TonyInvent/OpenIMU/3D/preview.png

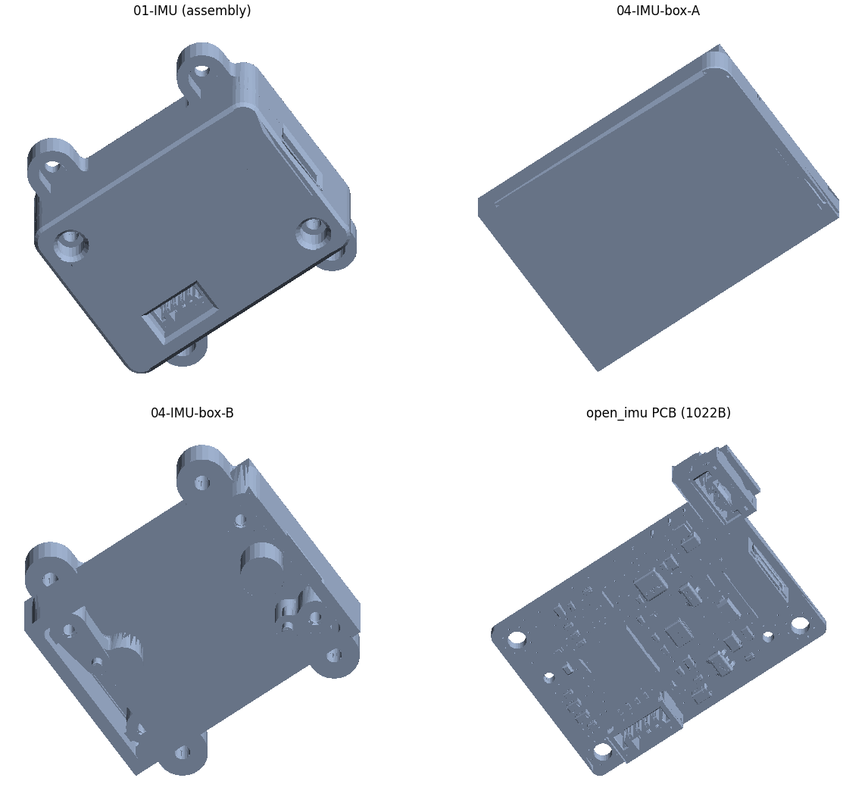
3D/preview.png
