TonyInvent/OpenIMU/3D/20261028/04-IMU-box-B.FCStd

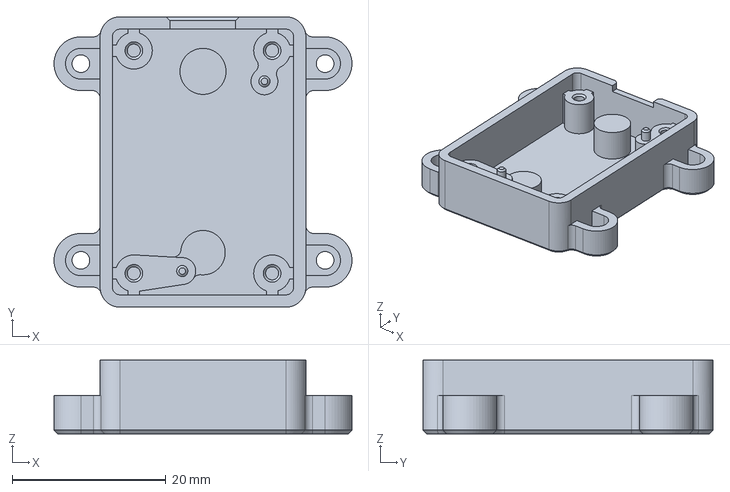
[picture p5: CAD file, 2026-10-28]
3D/20261028/04-IMU-box-B.FCStd
38.8 x 37.8 x 9.60 mm
