TonyInvent/OpenIMU/3D/20261028/04-IMU-box-A.FCStd

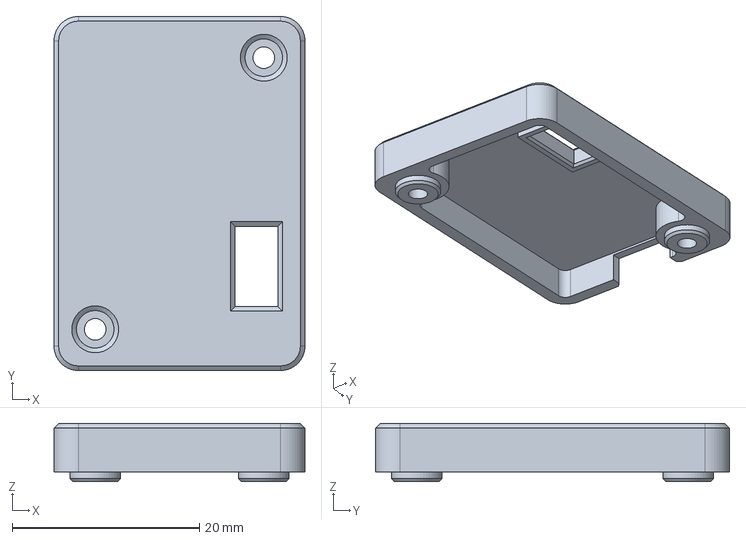
[picture p6: CAD file, 2026-10-28]
3D/20261028/04-IMU-box-A.FCStd
26.8 x 37.8 x 6.20 mm
