TonyInvent/OpenIMU/3D/20261028/open_imu_3D_1022B.FCStd

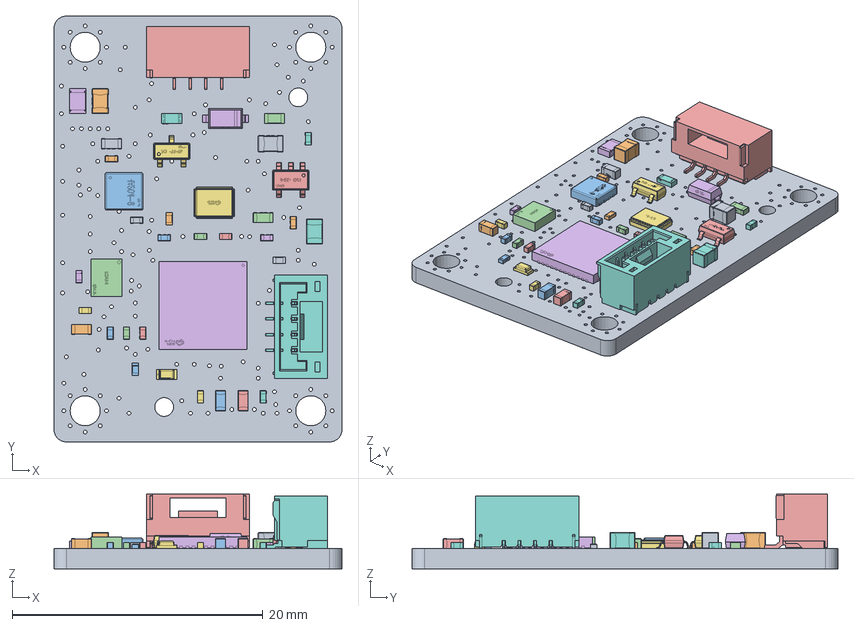
[picture p7: CAD file, 2026-10-28]
3D/20261028/open_imu_3D_1022B.FCStd
23.0 x 34.0 x 5.95 mm
Board~N964
C0402~C0402_L1.0-W0.5-H0.5~D99M
C0402~C0402_L1.0-W0.5-H0.5~D99M001
C0402~C0402_L1.0-W0.5-H0.5~D99M002
C0402~C0402_L1.0-W0.5-H0.5~D99M003
C0402~C0402_L1.0-W0.5-H0.5~D99M004
C0402~C0402_L1.0-W0.5-H0.5~D99M005
C0402~C0402_L1.0-W0.5-H0.5~D99M006
C0402~C0402_L1.0-W0.5-H0.5~D99M007
C0402~C0402_L1.0-W0.5-H0.5~D99M008
C0402~C0402_L1.0-W0.5-H0.5~D99M009
C0402~C0402_L1.0-W0.5-H0.5~D99M010
C0402~C0402_L1.0-W0.5-H0.5~D99M011
C0402~C0402_L1.0-W0.5-H0.5~D99M012
C0402~C0402_L1.0-W0.5-H0.5~D99M013
C0402~C0402_L1.0-W0.5-H0.5~D99M014
C0603~C0603_L1.6-W0.8-H0.8~f4fJ
C0603~C0603_L1.6-W0.8-H0.8~f4fJ001
C0603~C0603_L1.6-W0.8-H0.8~f4fJ002
C0603~C0603_L1.6-W0.8-H0.8~f4fJ003
C0603~C0603_L1.6-W0.8-H0.8~f4fJ004
SOD-123_L2.8-W1.8-LS3.7-RD~SOD-123_L2.8-W1.8-LS3.7-RD~P5vA
LED0603-RD_GREEN~LED0603-RD_GREEN~aO4a
R0603~R0603~sxD8
R0402~R0402_L1.0-W0.5-H0.4~tbHW
R0402~R0402_L1.0-W0.5-H0.4~tbHW001
R0402~R0402_L1.0-W0.5-H0.4~tbHW002
LGA-14_L3.0-W2.5-P0.50-TL~LGA-14_L2.5-W3.0-H0.9-P0.50~VYw3
CONN-SMD_4P-P1.25_XUNPU_WAFER-GH1.25-4PWB~CONN-SMD_4P-P1.25_XUNPU_WAFER-GH1.25-4PWB~I6nu
VQFN-48_L7.0-W7.0-P0.50-BL-EP5.5~VQFN-48_L7.0-W7.0-P0.50-BL-EP5.5~hn36
CRYSTAL-SMD_4P-L3.2-W2.5-BL~CRYSTAL-SMD_4P-L3.2-W2.5-BL~MRwp
C0805~C0805_L2.0-W1.3-H1.3~LhJX
C0805~C0805_L2.0-W1.3-H1.3~LhJX001
C0805~C0805_L2.0-W1.3-H1.3~LhJX002
HVSON-8_L3.0-W3.0-P0.65-BL-EP~HVSON-8_L3.0-W3.0-H0.85-P0.65-BL-EP~NhbZ
L0603~L0603_L1.6-W0.8-H0.5_BEAD~2BmU
TSOT-23-5_L2.9-W1.6-P0.95-LS2.8-BR~TSOT-23-5_L2.9-W1.6-H1.00-LS2.8-P0.95~nDk3
R0805~R0805_L2.0-W1.3-H0.6~Mn3l
SOT-23-3_L2.9-W1.3-P1.90-LS2.4-BR~SOT-23-3P_L2.9-W1.3-H1.0-LS2.4-P0.95~Hdi2
CONN-SMD_4P-P1.25_XUNPU_WAFER-GH1.25-4PLB~CONN-TH_4P-P1.25_XUNPU_WAFER-GH1.25-4PLB~gf5S
