TonyInvent/OpenIMU/(list of files, cad)

Other CAD files:
3D/20261028/01-IMU.FCStd
