TonyInvent/OpenIMU/open_imu.ioc

Mcu.UserName=STM32G431CBUx
PA11.Signal=FDCAN1_RX
PA12.Signal=FDCAN1_TX
PA13.Signal=SYS_JTMS-SWDIO
PA14.Signal=SYS_JTCK-SWCLK
PA4.Signal=SPI1_NSS
PA5.Signal=SPI1_SCK
PA6.Signal=SPI1_MISO
PA7.Signal=SPI1_MOSI
PB0.Signal=GPXTI0
PF0-OSC_IN.Signal=RCC_OSC_IN
PF1-OSC_OUT.Signal=RCC_OSC_OUT
