TonyInvent/OpenIMU/Core/Src/imu_task.c

/**
  ******************************************************************************
  * @file    imu_task.c
  * @brief   FreeRTOS task reading ICM-45686 samples on the INT1 data-ready
  *          interrupt and streaming them over CAN FD (ID 0x01) at 800 Hz.
  *
  *          Flow:
  *            ICM-45686 INT1 (800 Hz data-ready, active-high pulse)
  *                -> PB0 / EXTI0 (rising edge)
  *                -> HAL_GPIO_EXTI_Callback()
  *                -> vTaskNotifyGiveFromISR()
  *                -> IMU task reads 14 bytes over SPI and queues one 16-byte
  *                   CAN FD frame.
  *
  *          CAN FD frame (16 bytes, big-endian multi-byte fields):
  *            [0]    hardware timestamp high (1 us / tick, wraps at 65536 us)
  *            [1]    hardware timestamp low
  *            [2:3]  accel X  (raw int16)
  *            [4:5]  accel Y
  *            [6:7]  accel Z
  *            [8:9]  gyro X   (raw int16)
  *            [10:11]gyro Y
  *            [12:13]gyro Z
  *            [14:15]temperature (raw int16)
  ******************************************************************************
  */
#include "imu_task.h"
#include "icm45686.h"
#include "main.h"
#include "task.h"

/* External peripheral handles from main.c */
extern SPI_HandleTypeDef   hspi1;
extern FDCAN_HandleTypeDef hfdcan1;

/* ------------------------------------------------------------------------- */
/* Task configuration                                                        */
/* ------------------------------------------------------------------------- */
#define IMU_TASK_STACK_BYTES      (256U * 4U)   /* 256 words = 1024 bytes */

static const osThreadAttr_t imu_task_attributes = {
    .name       = "imuTask",
    .priority   = (osPriority_t) osPriorityHigh,
    .stack_size = IMU_TASK_STACK_BYTES
};

/* ------------------------------------------------------------------------- */
/* Status LED (PB2, current-sinking: LOW = ON)                               */
/* ------------------------------------------------------------------------- */
#define LED_GPIO_PORT            GPIOB
#define LED_GPIO_PIN             GPIO_PIN_2

#define LED_ON()      HAL_GPIO_WritePin(LED_GPIO_PORT, LED_GPIO_PIN, GPIO_PIN_RESET)
#define LED_OFF()     HAL_GPIO_WritePin(LED_GPIO_PORT, LED_GPIO_PIN, GPIO_PIN_SET)
#define LED_TOGGLE()  HAL_GPIO_TogglePin(LED_GPIO_PORT, LED_GPIO_PIN)

/* Blink timing */
#define LED_RUN_TOGGLE_FRAMES    100U   /* normal: toggle every 100 frames (~125 ms @ 800 Hz) */
#define LED_ERROR_BLINK_MS       30U    /* error:  toggle every 30 ms (fast blink)             */

/* ------------------------------------------------------------------------- */
/* Private variables                                                         */
/* ------------------------------------------------------------------------- */
static TaskHandle_t imu_task_handle = NULL;   /* used for ISR -> task notify */

/* Diagnostics (inspect in the debugger) */
volatile uint32_t imu_sample_count = 0U;      /* samples enqueued, not TX ACKs */
volatile uint32_t imu_fifo_backlog_count = 0U;/* frames skipped to stay current */
volatile uint32_t imu_fifo_overflow_count = 0U;/* FIFO_FULL status seen        */
volatile uint32_t imu_fifo_reset_count = 0U;  /* device reset seen            */
volatile uint32_t imu_missed_count  = 0U;     /* data-ready overruns         */
volatile uint32_t imu_can_error_count = 0U;   /* CAN queue failures          */
volatile uint32_t imu_spi_error_count = 0U;   /* SPI/FIFO read failures      */

/* Diagnostics: FDCAN protocol status + error counters, refreshed every frame.
 * These capture bus/bit errors that occur AFTER a frame is enqueued (which
 * imu_can_error_count, an enqueue result, cannot see). Watch BusOff,
 * ErrorPassive, LastErrorCode, DataLastErrorCode, TxErrorCnt in the debugger. */
FDCAN_ProtocolStatusTypeDef can_status = {0};
FDCAN_ErrorCountersTypeDef   can_errors  = {0};

static uint32_t led_error_last_tick = 0U;     /* last error fast-blink toggle (ms) */

/* ------------------------------------------------------------------------- */
/* Private function prototypes                                               */
/* ------------------------------------------------------------------------- */
static void IMU_Task(void *argument);

/* ------------------------------------------------------------------------- */
/* Helpers                                                                   */
/* ------------------------------------------------------------------------- */

/**
  * @brief  Pack one sample into the 16-byte CAN FD payload (big-endian).
  */
static void IMU_PackFrame(uint8_t *dst, uint16_t timestamp, const ICM45686_Data_t *d)
{
    dst[0]  = (uint8_t)(timestamp >> 8);
    dst[1]  = (uint8_t)(timestamp & 0xFFU);

    dst[2]  = (uint8_t)((uint16_t)d->accel[0] >> 8);
    dst[3]  = (uint8_t)((uint16_t)d->accel[0] & 0xFFU);
    dst[4]  = (uint8_t)((uint16_t)d->accel[1] >> 8);
    dst[5]  = (uint8_t)((uint16_t)d->accel[1] & 0xFFU);
    dst[6]  = (uint8_t)((uint16_t)d->accel[2] >> 8);
    dst[7]  = (uint8_t)((uint16_t)d->accel[2] & 0xFFU);

    dst[8]  = (uint8_t)((uint16_t)d->gyro[0] >> 8);
    dst[9]  = (uint8_t)((uint16_t)d->gyro[0] & 0xFFU);
    dst[10] = (uint8_t)((uint16_t)d->gyro[1] >> 8);
    dst[11] = (uint8_t)((uint16_t)d->gyro[1] & 0xFFU);
    dst[12] = (uint8_t)((uint16_t)d->gyro[2] >> 8);
    dst[13] = (uint8_t)((uint16_t)d->gyro[2] & 0xFFU);

    dst[14] = (uint8_t)((uint16_t)d->temp >> 8);
    dst[15] = (uint8_t)((uint16_t)d->temp & 0xFFU);
}

/**
  * @brief  Fast-blink the LED once per LED_ERROR_BLINK_MS (error indication).
  * @note   Called from the task loop on each error; the blink rate is limited
  *         by HAL_GetTick() so a burst of errors still produces a clean blink.
  */
static void LED_ErrorBlink(void)
{
    uint32_t now = HAL_GetTick();
    if ((now - led_error_last_tick) >= LED_ERROR_BLINK_MS) {
        LED_TOGGLE();
        led_error_last_tick = now;
    }
}

/**
  * @brief  Fatal error: fast-blink forever (init failure). Never returns.
  */
static void LED_FatalBlink(void)
{
    for (;;) {
        LED_TOGGLE();
        osDelay(LED_ERROR_BLINK_MS);
    }
}

/* ------------------------------------------------------------------------- */
/* Public API                                                                */
/* ------------------------------------------------------------------------- */

void IMU_StartTask(void)
{
    imu_task_handle = osThreadNew(IMU_Task, NULL, &imu_task_attributes);
}

/**
  * @brief  Called from EXTI0 ISR context; wakes the IMU task.
  */
void IMU_DataReadyFromISR(void)
{
    BaseType_t xHigherPriorityTaskWoken = pdFALSE;

    if (imu_task_handle != NULL) {
        vTaskNotifyGiveFromISR(imu_task_handle, &xHigherPriorityTaskWoken);
        portYIELD_FROM_ISR(xHigherPriorityTaskWoken);
    }
}

/**
  * @brief  HAL GPIO EXTI callback (called from EXTI0_IRQHandler via
  *         HAL_GPIO_EXTI_IRQHandler()).
  */
void HAL_GPIO_EXTI_Callback(uint16_t GPIO_Pin)
{
    if (GPIO_Pin == GPIO_PIN_0) {
        IMU_DataReadyFromISR();
    }
}

/* ------------------------------------------------------------------------- */
/* Task body                                                                 */
/* ------------------------------------------------------------------------- */

static void IMU_Task(void *argument)
{
    (void)argument;

    FDCAN_TxHeaderTypeDef TxHeader = {0};
    ICM45686_Data_t       imu      = {0};
    uint8_t               tx_data[IMU_CAN_DLC_BYTES];

    /* 0. Power-on indicator: turn the status LED solid ON. */
    LED_ON();

    /* 1. Initialise the IMU and start the FDCAN peripheral */
    if (ICM45686_Init(&hspi1) != HAL_OK) {
        /* IMU not present / miswired: fast-blink forever. */
        LED_FatalBlink();
    }

    /* 1a. FIFO streaming with the hardware timestamp (1 us / LSB):
     *     watermark = 1 frame, interrupt on count >= watermark, timestamp
     *     included in every 16-byte packet. Check the count after each wake:
     *     notifications may be stale and multiple packets may accumulate. */
    if (ICM45686_ConfigFifo() != HAL_OK) {
        LED_FatalBlink();
    }

    /* 1b. Enable transmitter delay compensation (TDC) for the 5 Mbit/s data
     *     phase. Must be configured while the FDCAN is still in READY state
     *     (i.e. before HAL_FDCAN_Start).
     *     SSP = measured loop delay + TDCO, both in "minimum time quantum"
     *     (mtq) units. With the FDCAN kernel clock at 100 MHz (FDCAN_CLOCK_DIV1),
     *     1 mtq = 10 ns, so TDCO = 16 places the sample point ~160 ns inside
     *     the data bit, away from the edge. (TDCO = 0 samples at the edge and
     *     produces bit errors in the 5 Mbit/s data phase.) */
    if (HAL_FDCAN_ConfigTxDelayCompensation(&hfdcan1, 16U, 0U) != HAL_OK) {
        LED_FatalBlink();
    }
    if (HAL_FDCAN_EnableTxDelayCompensation(&hfdcan1) != HAL_OK) {
        LED_FatalBlink();
    }

    if (HAL_FDCAN_Start(&hfdcan1) != HAL_OK) {
        /* FDCAN failed to start: fast-blink forever. */
        LED_FatalBlink();
    }

    /* 2. Prepare the (constant) CAN FD TX header */
    TxHeader.Identifier          = IMU_CAN_ID;
    TxHeader.IdType              = FDCAN_STANDARD_ID;
    TxHeader.TxFrameType         = FDCAN_DATA_FRAME;
    TxHeader.DataLength          = FDCAN_DLC_BYTES_16;
    TxHeader.ErrorStateIndicator = FDCAN_ESI_ACTIVE;
    TxHeader.BitRateSwitch       = FDCAN_BRS_ON;
    TxHeader.FDFormat            = FDCAN_FD_CAN;
    TxHeader.TxEventFifoControl  = FDCAN_NO_TX_EVENTS;
    TxHeader.MessageMarker       = 0U;

    /* 3. Enable the INT1 / EXTI0 data-ready interrupt (FreeRTOS-safe priority) */
    HAL_NVIC_SetPriority(EXTI0_IRQn, 5, 0);
    HAL_NVIC_ClearPendingIRQ(EXTI0_IRQn);
    HAL_NVIC_EnableIRQ(EXTI0_IRQn);

    /* 4. Acquisition loop: one CAN FD frame per data-ready pulse (800 Hz) */
    for (;;) {
        uint32_t notified = ulTaskNotifyTake(pdTRUE, portMAX_DELAY);

        /* Auto-recover from bus-off. Without a receiver every frame gets an
         * ACK error, which eventually drives the FDCAN into bus-off; clearing
         * INIT lets it recover and keep transmitting. This makes the board
         * plug-and-play with the USB-CAN dongle (no power-up order needed). */
        if ((hfdcan1.Instance->PSR & FDCAN_PSR_BO) != 0U) {
            hfdcan1.Instance->CCCR &= ~FDCAN_CCCR_INIT;
        }

        if (notified > 1U) {
            imu_missed_count += (notified - 1U);
        }

        uint16_t timestamp = 0U;

        /* Keep the FIFO shallow: if a scheduling hiccup let more than one frame
         * queue up, drop the stale ones and transmit only the newest sample.
         * Without this a single stall would leave a permanent latency offset,
         * because each interrupt only ever drains one frame. */
        {
            uint16_t pending = 0U;
            if (ICM45686_ReadFifoCountChecked(&pending) != HAL_OK) {
                imu_spi_error_count++;
                LED_ErrorBlink();
                continue;
            }
            if (pending == 0U) {
                continue;
            }
            while (pending > 1U) {
                if (ICM45686_ReadFifoPacket(&imu, &timestamp) != HAL_OK) {
                    imu_spi_error_count++;
                    pending = 0U;
                    break;
                }
                imu_fifo_backlog_count++;
                pending--;
            }
            if (pending == 0U) {
                LED_ErrorBlink();
                continue;
            }
        }

        if (ICM45686_ReadFifoPacket(&imu, &timestamp) != HAL_OK) {
            imu_spi_error_count++;
            LED_ErrorBlink();
            continue;
        }

        {
            uint8_t fifo_status = 0U;
            if (ICM45686_ReadFifoStatus(&fifo_status) == HAL_OK) {
                if ((fifo_status & ICM45686_STATUS_FIFO_FULL) != 0U) {
                    imu_fifo_overflow_count++;
                }
                if ((fifo_status & ICM45686_STATUS_RESET_DONE) != 0U) {
                    imu_fifo_reset_count++;
                }
            } else {
                imu_spi_error_count++;
                LED_ErrorBlink();
                continue;
            }
        }

        /* [0:1] of the CAN frame carries the sensor's hardware timestamp. */
        IMU_PackFrame(tx_data, timestamp, &imu);

        /* Snapshot protocol status + error counters before queuing the next
         * frame, so post-enqueue bus/bit errors stay visible in the debugger. */
        HAL_FDCAN_GetProtocolStatus(&hfdcan1, &can_status);
        HAL_FDCAN_GetErrorCounters(&hfdcan1, &can_errors);

        if (HAL_FDCAN_AddMessageToTxFifoQ(&hfdcan1, &TxHeader, tx_data) != HAL_OK) {
            imu_can_error_count++;
            /* Frame dropped (TX FIFO full / bus error): fast-blink. */
            LED_ErrorBlink();
        } else {
            imu_sample_count++;
            /* Normal operation: toggle the LED every 100 transmitted frames. */
            if ((imu_sample_count % LED_RUN_TOGGLE_FRAMES) == 0U) {
                LED_TOGGLE();
            }
        }
    }
}
