TonyInvent/OpenIMU/(commit log)

2026-10-21 Initial commit: ICM-45686 IMU (SPI) + CAN FD transmission @ 800 Hz (STM32G431)
2026-10-21 Add status LED (PB2) UI behavior
2026-10-27 Fix IMU bring-up and enable stable CAN FD 16-byte transmission
    - SPI: software CS (PA4), Mode 3, 12.5 MHz (fixes register writes)
    - ICM-45686: corrected init order (DRDY routing enabled after power-on), low-noise UI LPF BW = ODR/4, write + readback verification
    - Accel full-scale corrected to +/-4 g (8192 LSB/g)
    - FDCAN: enable TDC (TDCO=16) for the 5 Mbit/s data phase; auto-recover from bus-off so no receiver power-up ordering is needed
    - Diagnostics: expose FDCAN protocol status + error counters; drop leftover debug globals
2026-10-27 Update README: software SPI chip-select, TDC, and bus-off auto-recovery
    - SPI: PA4 is a software-controlled CS (Mode 3), not hardware NSS
    - Document TDC (TDCO=16, 1 mtq = 10 ns) required for the 5 Mbit/s data phase
    - Document bus-off auto-recovery (no receiver power-up ordering needed)
    - Note the driver now sets the UI low-pass filter to ODR/4
    - Add can_status / can_errors to the diagnostic counters table
2026-10-27 Document ICM-45686 SPI mode/software CS and UI LPFBW encoding
    - Header: SPI is Mode 3 with software CS on PA4 (the old Mode 0 / hardware NSS note was stale)
    - Document the ui_lpfbw_sel encoding (0=OFF, 1=ODR/4 ... 6=ODR/128) and its source (TDK driver / Zephyr dt-bindings)
2026-10-27 Match TDK/BeijingDynamics UI low-pass filter write (read-modify-write)
    - Keep UI LPFBW = ODR/4, the same value used by BeijingDynamics open_sprite_runtime and the TDK reference driver
    - Write only the 3-bit accel_ui_lpfbw_sel / gyro_ui_lpfbw_sel field via read-modify-write (mirrors inv_imu_set_accel_ln_bw / inv_imu_set_gyro_ln_bw) instead of overwriting the whole MREG byte
2026-10-27 Correct end-to-end latency definition in READMEs
    - Measure latency from 'sample ready' to the CAN FD frame being fully on the bus (16 data bytes + CRC + ACK/EOF), not to the first data byte
    - Total = sensor group delay (1-3 ms) + MCU path (~15-20 us) + full frame (~70-80 us) = group delay + ~85-100 us
    - Update the jitter/frame-loss section consistently (~7-8% of the 1.25 ms period)
2026-10-27 Add Linux candump (SocketCAN) setup section to READMEs
    - Document bringing up the CAN FD interface: bitrate 1000000, dbitrate 5000000, fd on
    - Show candump usage and the expected frame format (ID 0x001, [16] bytes)
    - Add a short Python snippet to decode the 16-byte big-endian payload
2026-10-28 Add cross-platform Python AHRS demo (Mahony/Madgwick/SixAxis)
    - tools/ahrs_demo.py: python-can backend (SocketCAN on Linux, PCAN-Basic on Windows), 16-byte CAN FD frame decode, three attitude estimators on the same samples, live 3-D attitude / roll-pitch / world-frame linear-acceleration plots
    - SixAxis is a Python port of BeijingDynamics open_sprite_runtime native/src/imu_six_axis.hpp
    - --simulate (no hardware), --no-plot, --duration, --log CSV
    - READMEs: new section 8 with install/run instructions; ignore __pycache__
2026-10-28 Add FreeCAD 3D models for the IMU board
    - 3D/20261028/: FreeCAD models (IMU carrier, enclosure variant A/B, assembled model), ~6 MB total
    - 3D/README.md: file listing
    - .gitattributes: treat *.FCStd as binary (zip archive, no EOL conversion)
2026-10-28 Add 3D preview and document the enclosure in the READMEs
    - 3D/preview.png: rendered 2x2 grid (assembly, box A/B, PCB) from the FreeCAD models
    - tools/export_3d_stl.py + tools/render_3d_preview.py: reproducible pipeline (FreeCADCmd STL export -> matplotlib render)
    - READMEs: new section 9 with the preview and a PETG printing recommendation
    - 3D/README.md: accurate part descriptions (assembly / box A / box B / PCB)
    - .gitignore: build/ (generated STL meshes)
2026-10-28 Use FreeCAD screenshot for the 3D preview; drop render tooling
    - Replace the rendered 2x2 preview with 3D/open_imu.png (FreeCAD screenshot of the assembly)
    - Remove tools/export_3d_stl.py and tools/render_3d_preview.py
    - Update the image links in README.md, readme_cn.md and 3D/README.md
2026-10-28 Show yaw angle and drift rate in the AHRS demo
    - Add a wide unwrapped-yaw plot (3 filters) and a 'yaw ... (deg/s)' readout in the title
    - Print roll/pitch/yaw for all three filters in --no-plot mode
    - Yaw is unobservable from the accelerometer, so on a static board its slope is the residual gyro bias
    - READMEs: document how to read the yaw plot for static-drift assessment
2026-10-28 Print the current yaw to the console while the demo window is open
    - 4 Hz console line 'yaw ... deg (roll, pitch)' so the board can be aligned while watching the terminal
    - The plot title still shows yaw + drift rate
2026-10-29 Add pure-gyro dead-reckoning demo (attitude + velocity)
    - tools/gyro_dead_reckoning.py: 10 s static calibration (gyro bias + roll/pitch from gravity, yaw = 0), then gyro-only quaternion integration (no accelerometer correction)
    - Rotates the accelerometer into the world frame, removes gravity, integrates once for velocity
    - Live 3-D attitude, motion-acceleration, velocity plots + console velocity readout
    - --simulate mode with a realistic moving board, --no-plot, --duration
    - READMEs: mention the companion demo
2026-10-29 Add displacement (double integration) to the dead-reckoning demo
    - Integrate the velocity once more for position (X-Y-Z + |p|)
    - New 2x3 layout: attitude, motion acceleration, velocity, X-Y drift path, position vs time, info panel
    - Console output and info panel include the current position
    - Simulate mode: phase-aligned acceleration so velocity/position start at zero
    - READMEs: mention the displacement path
2026-10-29 Add a Reset v/p button to the dead-reckoning demo
    - matplotlib Button at the bottom of the window
    - Clicking it zeroes the velocity and position integration, clears the plot histories and restarts the elapsed-time/drift stats
    - READMEs: document the button
2026-10-29 Fix reset-button comment to match behaviour (plots restart from zero)
2026-10-29 Add zero-velocity update (ZUPT) to the dead-reckoning demo
    - ZuptDetector: |gyro| and | |a|-g | thresholds over a sliding window (>=90% still)
    - When active, the velocity is forced to zero so the position stops drifting at rest
    - --zupt plus --zupt-gyro-th / --zupt-accel-th / --zupt-window
    - Info panel and console show the ZUPT state and activation count
    - Simulate mode alternates 3 s moving / 2 s static so ZUPT is exercised
    - READMEs: document the option
2026-10-29 Make ZUPT the default and reset the position on zero-velocity
    - ZUPT is now enabled by default; use --no-zupt to compare against raw open-loop integration
    - When the detector fires, both velocity and position are reset to zero, so every stop re-anchors the origin (short-term displacement only)
    - READMEs: update the ZUPT description
2026-10-29 Track the gyro bias online during ZUPT to compensate temperature drift
    - While ZUPT is active the gyro reading is the bias, so it is low-passed into the bias estimate (--bias-tau, default 2 s)
    - Startup calibration default reduced from 10 s to 2 s: a reset no longer needs a long static wait
    - Simulate mode adds a slowly drifting gyro bias to exercise the tracking
    - Console and info panel display the current bias
    - READMEs updated
2026-10-29 Remove the gyro dead-reckoning demo
    - Delete tools/gyro_dead_reckoning.py: pure-gyro open-loop integration + double integration does not hold up on this IMU class
    - Remove the related paragraphs (Reset button, ZUPT) from both READMEs
    - tools/ now only contains ahrs_demo.py
2026-10-30 Use the ahrs library for Mahony/Madgwick/EKF; compare four filters
    - Mahony, Madgwick and EKF now come from Mayitzin/ahrs (numpy-only online updateIMU/update), SixAxis stays a direct port of BeijingDynamics imu_six_axis.hpp
    - The demo now compares four estimators live (3-D body axes, roll/pitch/yaw, linear acceleration) and reports dq vs SixAxis
    - --madgwick-beta renamed to --madgwick-gain (ahrs gain_imu)
    - Install adds 'ahrs'; READMEs updated (algorithm table, install, options)
2026-10-30 Give all four estimators the same bias-calibrated gyro
    - Default: subtract the calibrated bias once, before feeding every filter (fair comparison)
    - --raw-gyro: feed the raw stream; only SixAxis then applies its internal calibrated bias
    - Removes the EKF roll/pitch offset and the yaw-drift gap caused by feeding raw gyro to the ahrs filters only
    - READMEs: document the switch
2026-10-30 Split AHRS demos: restore the original 3-filter demo, add ahrs-library comparison
    - tools/ahrs_demo.py restored to the hand-written Mahony/Madgwick/SixAxis version (only python-can + numpy + matplotlib)
    - tools/ahrs_lib_compare.py: new 4-filter comparison (Mahony/Madgwick/EKF from Mayitzin/ahrs + the local BeijingDynamics SixAxis port), with the common bias-calibrated gyro by default and --raw-gyro to feed the raw stream
    - READMEs: section 8 restored, new 8.3 documents the library-based comparison
2026-10-30 Fix double bias subtraction in the ahrs comparison demo
    - The SixAxis wrapper received the calibrated bias even when the gyro fed to it had already been bias-corrected, so the bias was subtracted twice and its yaw drifted fast (the bug showed up on hardware, not in the zero-bias sim)
    - SixAxis now only gets the calibrated bias with --raw-gyro (raw stream); otherwise its internal bias is zero
    - Simulate mode injects a realistic ~0.01-0.015 deg/s gyro bias so the bias path is exercised
2026-10-30 Add ESKF demos and a C++ Eigen ESKF; document them
    - eskf/eskf.hpp: 18-state error-state Kalman filter (p, v, R, bg, ba, g) in pure Eigen, with pose/position/velocity updates, a closed-loop demo, build.bat/CMake and a README
    - tools/eskf_zaru.py: 3-state attitude ESKF (right perturbation on so(3)) with a zero-angular-rate update, reusing the pyqtgraph dashboard and CAN-FD acquisition from tools/eskf.py
    - tools/eskf.py: reference 3-state attitude ESKF
    - README/readme_cn: sections 8.4 (ESKF live demo) and 8.5 (C++ ESKF)
    - All code comments are English; readme_cn.md stays Chinese
2026-10-30 Remove the C++ ESKF project
    - The 18-state Eigen ESKF (eskf/) is not used by this project: the 6-axis attitude filter lives in Python (tools/eskf_zaru.py) and the 18-state needs external position/velocity observations
    - Drop the associated README sections and the local toolchain (w64devkit/Eigen) ignore rules
    - The local .toolchain/ (portable MinGW + Eigen) was deleted as well
2026-10-30 Tune eskf.py: smaller initial attitude covariance and gyro process noise
    - P: 1e-3 -> 1e-4 (sigma 1.8 deg -> 0.57 deg), the calibrated initial attitude is trusted more
    - var_g: (0.05 deg/s)^2 -> (0.008 deg/s)^2, so the filter leans on the gyro and uses the accelerometer more gently
    - Verified on hardware by the author: convergence speed is good
2026-10-30 Decouple CAN reception from the ESKF so no frame is dropped
    - Dedicated receive thread: bus.recv + decode + enqueue only, so the PCAN driver queue is drained at full speed
    - ESKF runs in the worker thread on an unbounded queue; a slow filter or GUI can no longer overflow the driver
    - Removed the batch truncation (batch[-32:]) that silently discarded older frames when a batch exceeded 80
    - The firmware already checks HAL_FDCAN_AddMessageToTxFifoQ, so TX-side drops remain visible via imu_can_error_count
2026-10-30 Remove the per-frame setStyleSheet (Qt style re-polish starved the ESKF)
    - The dashboard called header.setStyleSheet() every 15 ms; Qt re-polishes the widget each time (several ms) and holds the GIL, so the ESKF thread only got ~115 Hz
    - Measured ESKF cost is 0.186 ms/frame and ZARU 0.143 ms/frame: the algorithm can easily sustain 800 Hz, the GUI was the bottleneck
    - The stylesheet is now set once in __init__
2026-10-30 Decimate plot data while copying to stop starving the ESKF thread
    - The dashboard converted the full 5 s deques (4200 samples x 7 buffers) every 15 ms: ~2.5 ms of np.array plus a 24k-point redraw, holding the GIL long enough to cap the ODR at ~115 Hz
    - np.fromiter(islice(buf, 0, None, step)) keeps ~900 points per buffer for ~0.3 ms
    - Combined with the earlier setStyleSheet fix and the decoupled receiver, the ESKF thread should now sustain the full 800 Hz
2026-10-30 Drop the dashboard refresh to 30 Hz to halve GUI GIL contention
    - The 15 ms timer plus the decimated copy still held the GIL long enough to drag the effective ODR down over time
    - 33 ms is plenty for a 5 s window and cuts the time the ESKF thread waits for the lock
2026-10-30 Report the real sensor ODR and the display backlog separately
    - 'ODR' used to be the processed frame rate, which spiked to ~1700 Hz while the consumer drained a backlog (e.g. after a Windows screenshot stalls the GUI) and looked like a sensor fault
    - ODR is now measured from the receive thread (actual arrivals); FPS is the processed rate; Backlog is the queue depth, i.e. the display latency
    - Dropped stays 0 in all cases, so no data is lost - only the display lags while catching up
2026-10-30 Replace the plot deque buffers with a lock-free numpy ring and tune GC
    - _History: fixed-size (window x 7) float64 ring, O(1) lock-free push, snapshot is a numpy slice decimated to ~900 points
    - The GUI no longer takes a lock nor iterates ~29k Python objects per refresh, so the ESKF thread keeps the full 800 Hz
    - gc.freeze() + relaxed thresholds keep a large receive backlog from triggering long full-collection pauses
    - Both ZARU subclasses follow the new push
2026-10-30 Make the 5-state frame path 2.8x faster (ZARU O(1), closed-form 2x2 inverse)
    - Profiling showed ZARU.push at 40% (re-scanning the 240-entry window with two generators every frame, ~3.9M calls) and np.linalg.inv at 14%
    - ZARU now keeps running duration/sum/still-count, so push is O(1)
    - update_bias_xy uses a closed-form 2x2 inverse instead of the LAPACK call
    - Per-frame cost measured: 1.113 ms -> 0.393 ms (2544 frame/s single threaded), 800 Hz needs 31% of one core
2026-10-30 Update the README screenshot: 800 Hz streaming with zero backlog
    - New capture shows ODR 808 Hz, FPS 810, Backlog 0, Dropped 0 after the performance work (lock-free ring, O(1) ZARU, 2.8x faster frame path)
2026-10-30 Make the 3-state demo's ZARU O(1) as well
    - Same running duration/sum/still-count approach as the 5-state version
    - ZARU.push measured 0.143 ms -> 0.0087 ms per frame (16x)
2026-11-06 Use the ICM-45686 hardware timestamp in place of the seq field
    - Driver: ICM45686_ConfigFifo() enables the 1 us timestamp counter (MREG SMC_CONTROL_0), streams accel+gyro with fifo_tmst_fsync_en, sets watermark = 1 FRAME (the FIFO counts frames, not bytes) and FIFO_WM_GT_TH, and routes INT1 to the FIFO watermark instead of DRDY
    - ICM45686_ReadFifoPacket() drains exactly one 18-byte packet (14 bytes of sensor data + 2-byte timestamp) per interrupt; the FIFO never accumulates
    - imu_task.c: one FIFO packet per interrupt, timestamp written to CAN bytes [0:1] - the frame stays 16 bytes
    - Host: dt now comes from the hardware timestamp with 16-bit wrap unwrapping ((ts - last) & 0xFFFF) at 1 us/LSB,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
2026-11-06 Enable fifo_if_en (FIFO_CONFIG3 bit0) - the FIFO data path was closed
    - Without fifo_if_en the accel/gyro never enter the FIFO, the watermark is never reached and INT1 never fires: the task blocked forever in ulTaskNotifyTake and PCAN-View saw no traffic at all
    - FIFO_CONFIG3 = fifo_if_en | accel_en | gyro_en (0x07)
2026-11-06 Enlarge the SPI transfer buffer so the 18-byte FIFO packet fits
    - ICM45686_ReadRegisters rejected len > 16 before touching SPI, so ICM45686_ReadFifoPacket (18 bytes) always returned HAL_ERROR and the task took the LED_ErrorBlink() path
    - tx/rx grow to 19 bytes (1 address + 18 data)
    - build: text 28712, bss 14024 (unchanged footprint apart from stack)
2026-11-06 Read the full 20-byte FIFO packet (2-byte header + data + timestamp)
    - TDK's FIFO packet carries a 2-byte header before the 14 bytes of sensor data, so the 18-byte read shifted every field: flat on the table gave roll 105 deg, pitch -44 deg and az 3.2 g
    - Packet is now 20 bytes: header[0:2], accel/gyro/temp[2:16], timestamp[18:20]
    - SPI scratch buffers grow to 21 bytes
2026-11-06 Use the TDK 16-byte FIFO frame layout (header + accel + gyro + 1-byte temp + timestamp)
    Verified against TDK's own driver instead of guessing:
    - inv_imu_set_fifo_config(): fifo_frame_size = 8 bytes per enabled sensor => 16, not 18/20
    - inv_imu_get_fifo_frame() case 16: header at [0], accel [1:7], gyro [7:13], temp [13] (single byte), timestamp [14:16]
    - The previous 20-byte read shifted every field by two bytes and read the timestamp from outside the frame, which is why the first two CAN bytes were a frozen 0x7F7F and the attitude was garbage
    - ConfigFifo now follows TDK's ordering: disable data path -> configure -> flush and poll until the flush bit clears -> start stream -> set fifo_if_en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
2026-11-06 Keep the FIFO shallow: drop stale frames so latency cannot accumulate
    - Watermark is 1 frame and one interrupt drains one 16-byte frame, so the steady state is empty -> one frame -> read -> empty
    - But if the task is ever delayed, each interrupt still only drains one frame while one new frame arrives per period, so a backlog would persist forever
    - The loop now reads FIFO_COUNT first, discards all but the newest frame and counts them in imu_fifo_backlog_count (visible in the debugger); latency therefore bounds itself at one sample period
2026-11-06 Update the two matplotlib demos for the hardware timestamp
    - ahrs_demo.py / ahrs_lib_compare.py decoded bytes [0:1] as a sequence number; they now treat it as the ICM-45686 16-bit 1 us timestamp
    - dt for the filters now comes from the sensor timestamp with modulo-2**16 unwrapping, falling back to the arrival clock when the delta is implausible
    - Display label and CSV column renamed seq -> ts, decode_frame's local/docstring updated
    - All five tools under tools/ now agree on the 16-byte frame layout
2026-11-06 Use the hardware timestamp for the exact time base and for transport latency
    - Before: the timestamp only produced dt and the dropped-frame count; sim_time_sec accumulated the clamped dt, so every >20 ms gap silently lost time and the plot x-axis drifted from the real sensor clock
    - Now an unwrapped 64-bit microsecond counter (ts_us) is maintained from the raw deltas, so sim_time_sec = ts_us * 1e-6 is exact across wraps and gaps; the number of 16-bit rollovers is counted
    - The receive thread compares the host arrival clock (msg.timestamp) with the sensor counter; the best case is tracked and the excess is reported as Lag (us) in the dashboard - an end-to-end transport latency figure that doe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
2026-11-06 Integrate the interval the sensor actually measured instead of a nominal step
    - The three ESKF scripts replaced any dt above 20 ms with NOMINAL_DT, so a stall or a burst of dropped frames was integrated as if only 1.25 ms had elapsed - exactly the case where the interval stops being correct
    - A 16-bit 1 us counter only becomes ambiguous within 6 ms of its 65.536 ms wrap, so the fallback now triggers above 60 ms; every ordinary interval is integrated as measured
    - Dropped-frame accounting unchanged
2026-11-06 Docs: frame byte 0:1 is the hardware timestamp, not a sequence number
    - Both READMEs: frame table, byte-layout sketch, decode prose and the Python example now describe timestamp[0:1] (16-bit, 1 us/LSB, 65.536 ms wrap)
    - Added the rule that deltas must be taken modulo 2**16, since that is what makes the interval correct across a wrap
    - Pin table and sample-trigger table now say FIFO watermark instead of data-ready
2026-11-06 Drop the Lag readout: it measured clock drift, not transport latency
    - The metric compared msg.timestamp (host clock, from the PCAN driver) with the sensor's microsecond counter. The two oscillators differ by ~1.4% (which is why ODR reads 811 instead of 800), so the difference drifts monotonically; subtracting a running minimum turned that drift into an ever-growing number (192 ms after a few minutes) that had nothing to do with latency
    - Removed the metric and its state instead of shipping a misleading figure; the timestamp keeps doing the one job that matters, producing the correct sampling interval
    - Verified: compile ok, eskf_zaru5 --simulate runs
2026-11-06 Docs: describe the FIFO watermark path instead of the DRDY interrupt
    - Data-flow diagram: the pulse now comes from the FIFO reaching one frame, not from the sensor's data-ready
    - MCU processing path headings/tables: added the ~11 us SPI read of one 16-byte FIFO frame per interrupt
    - imu_missed_count now described as coalesced task notifications rather than data-ready overruns
2026-11-06 Refresh the README screenshot: 800 Hz streaming, zero backlog, timestamp build
    - Capture after the FIFO/timestamp rework: ODR 802 Hz, FPS 802, Backlog 0, Dropped 0
2026-11-06 Use the clean capture for the README screenshot
    - ODR 791 / FPS 789 / Backlog 1 / Dropped 0 with continuous bias traces (the previous capture caught a bias step right after motion)
2026-11-06 Harden the FIFO path with six items borrowed from PR #1 (wire format unchanged)
    - FIFO_COUNT is read twice and the second value used (AN-000364 2.2)
    - INT1_STATUS0 is polled each frame; FIFO_FULL and RESET_DONE drive imu_fifo_overflow_count / imu_fifo_reset_count instead of silently dropping
    - FIFO header tag is captured on the first frame and must stay constant; a change invalidates the frame (icm45686_frame_errors)
    - data endianness follows SREG_CTRL for both register and FIFO decoding
    - FIFO configuration writes are read back and verified (ICM45686_WriteRegisterChecked)
    - ODR_DECIMATE is cleared and FSYNC tag selection disabled, which the previous config never touched
    - Wire format untouc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
2026-11-12 Fix FIFO startup validation and checked read recovery
    Validate each packet, preserve valid FIFO depth and propagate FIFO configuration/read failures. Add native driver and acquisition-task regression coverage without changing CAN timing or the wire format.
2026-11-13 Let the window close button stop ahrs_demo / ahrs_lib_compare
    Closing the window left the render loop running and Ctrl+C unresponsive, so
    the only way out was to kill the terminal.
    - The render loop no longer calls plt.pause(). On the Qt backend that runs a
    nested event loop with a quit timer; destroying the window from inside it
    stranded the timer and froze the process ("Python not responding").
    canvas.flush_events() draws and dispatches without a nested loop.
    - close_event now exits the process directly, so shutdown cannot depend on the
    loop noticing the click.
    - close() only marks the figure closed: teardown never calls back into pyplot,
    which used to block on the backend's own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
